julianvbw/ble-esp32-pilldispenser/schematics/Acrylic_cutandengraving.pdf

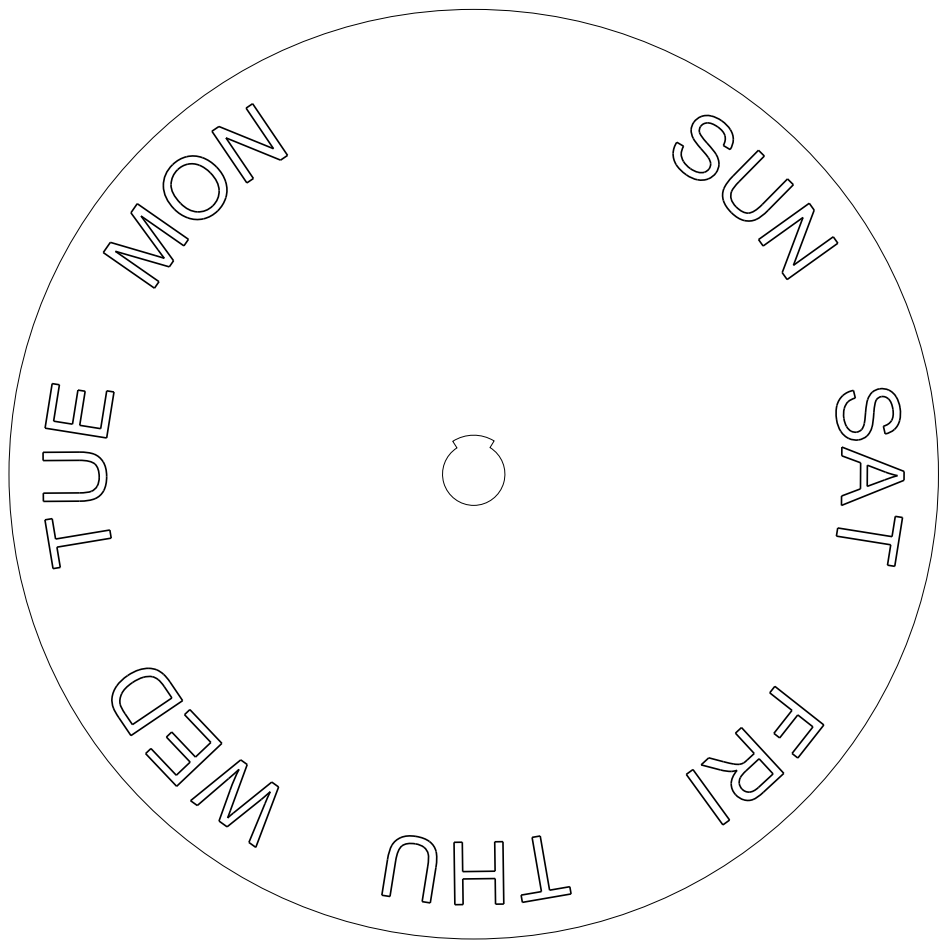
[picture p8: page 1]
