julianvbw/ble-esp32-pilldispenser/(commit log)

2024-06-03 Added schematics
2024-06-12 Fixed firmware rotation issue
    [firmware.ino]
